chkummer/klonk/README.md

# klonk
A single key USB keyboard that helps you at typing your password. It is build using an Arduino comaptible board called 'Pro Micro' and an RFID board called 'MFRC522'.
