chkummer/klonk/case/README.md

#Case 
This folder contains files for the case which you may 3d print.
The case was degigned using TurboCAD (<filename>.tcd) and then exported into DXF (<filename>.dxf) for importing into other CAD Applications and into STL (<filename>.stl) files for importing them into a Slicer-Software (to prepare for your 3D Printer). 

##Files

###klonk_rfid_rc522 case
Printed 3d case
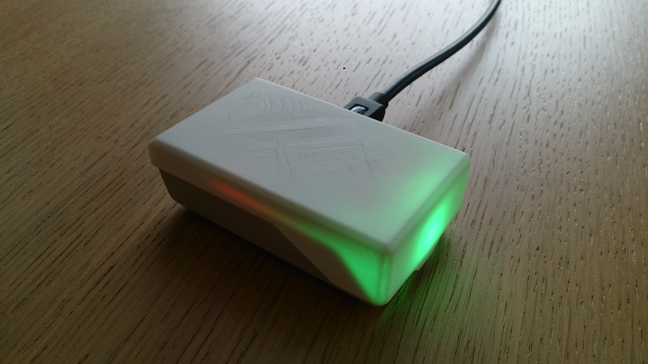
[picture p1: case/klonk_rfid_rc522_case.jpg]
3d case

Breadboard view
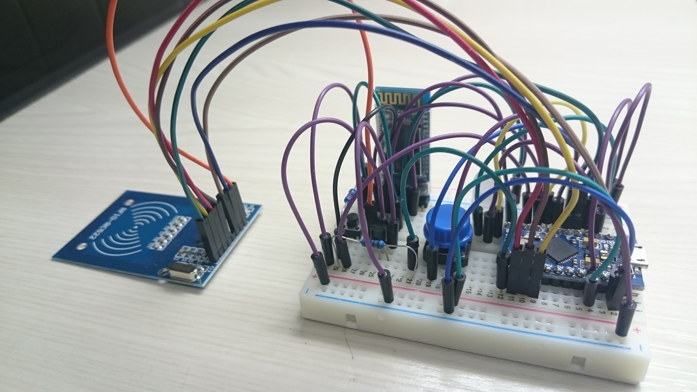
[picture p2: case/klonk_rfid_rc522_bb.jpg]

Electronic parts
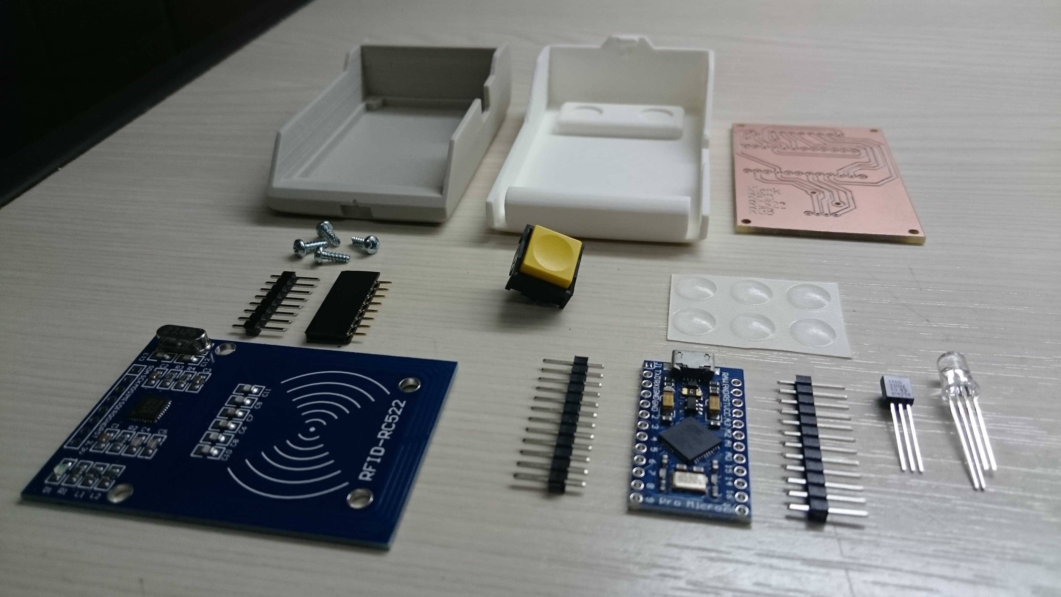
[picture p3: case/klonk_rfid_rc522_parts_01.jpg]

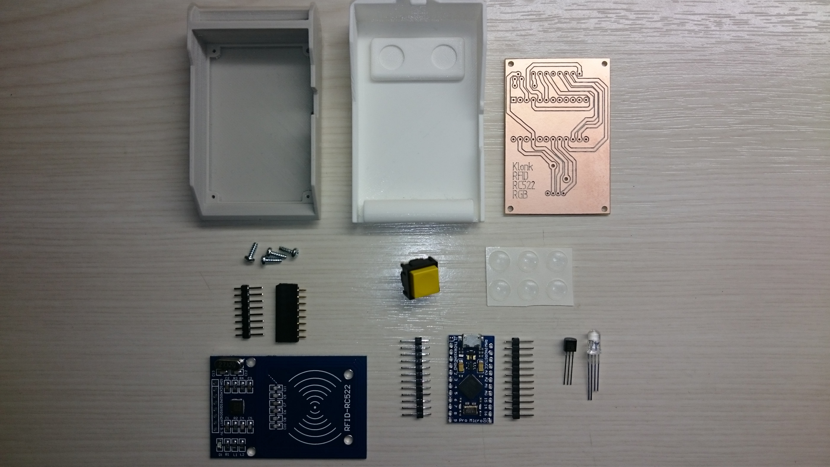
[picture p4: case/klonk_rfid_rc522_parts_02.jpg]

Electronic parts soldered
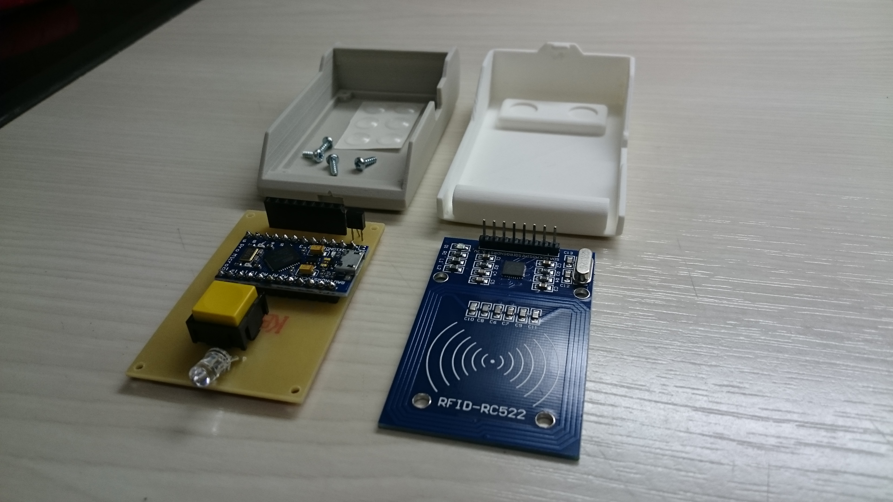
[picture p5: case/klonk_rfid_rc522_soldered.jpg]


###klonk_fingerprint case
Customised standard box case
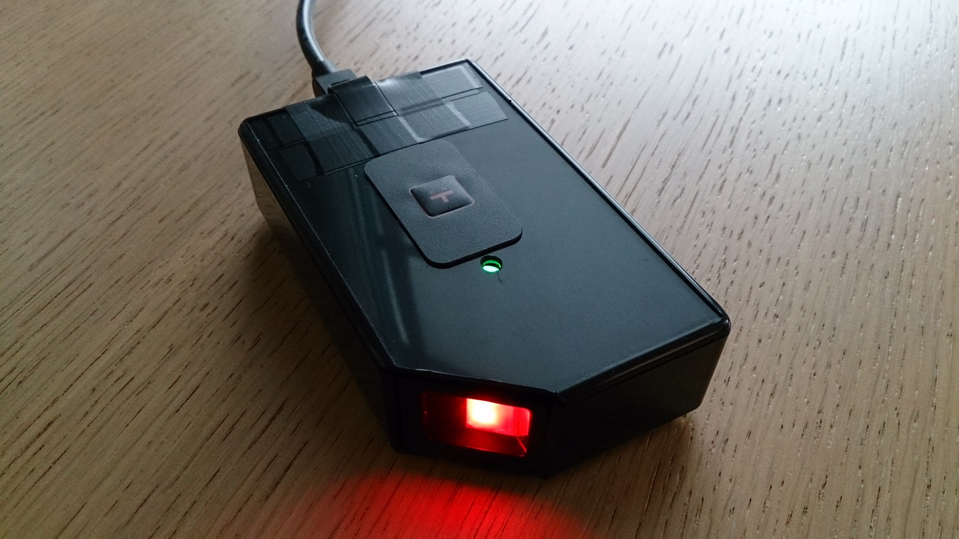
[picture p6: case/klonk_fp_case.jpg]
Customised case

Breadboard view
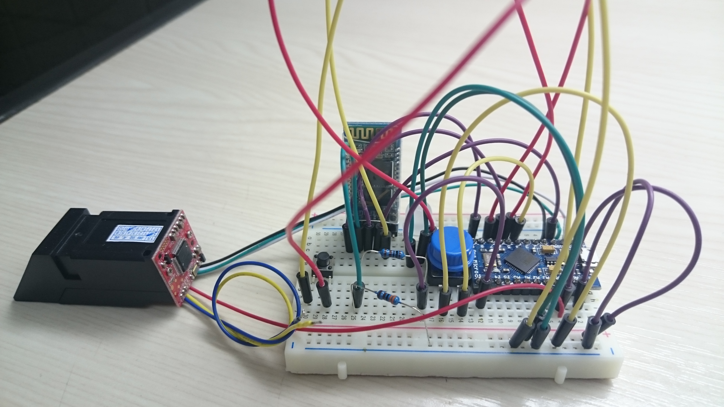
[picture p7: case/klonk_fb_bb.jpg]
