chkummer/klonk/electronics/klonk_rfid_rc522_green_led/klonk_bt.png

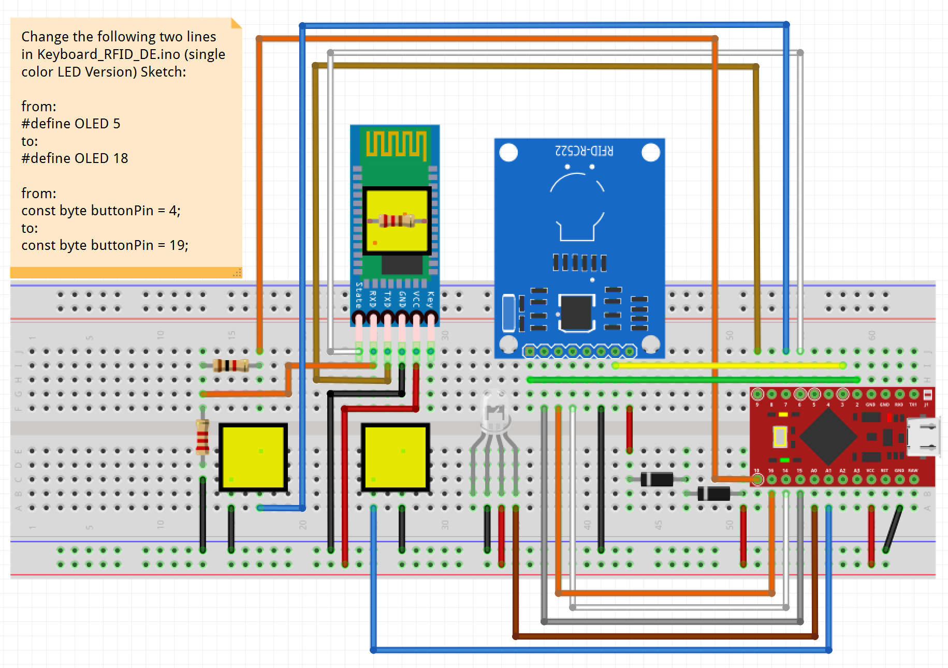
electronics/klonk_rfid_rc522_green_led/klonk_bt.png
