chkummer/klonk/case/klonk_top.stl

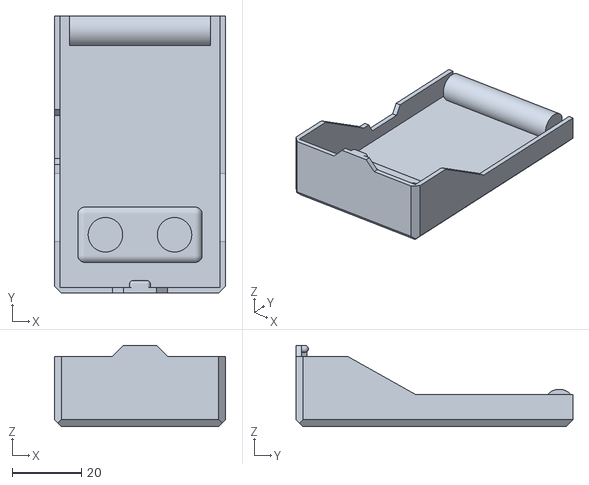
[picture p15: CAD file, 2016-12-01]
case/klonk_top.stl
49.6 x 80.2 x 23.5
