chkummer/klonk/case/klonk_base.stl

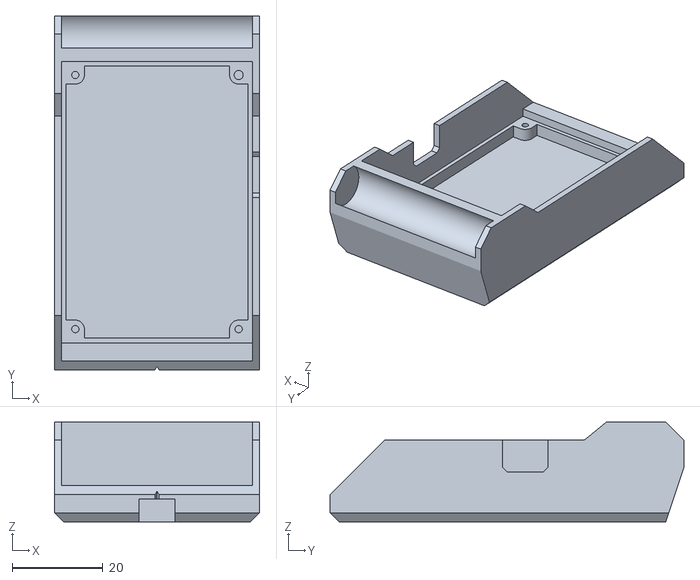
[picture p16: CAD file, 2016-10-09]
case/klonk_base.stl
45.2 x 78.0 x 22.0
