chkummer/klonk/(list of files, cad)

Other CAD files:
case/klonk_base.dxf
case/klonk_top.dxf
