chkummer/klonk/electronics/klonk_rfid_rc522_rgb_led/klonk_rfid_rc522_rgb_led_pcb.pdf

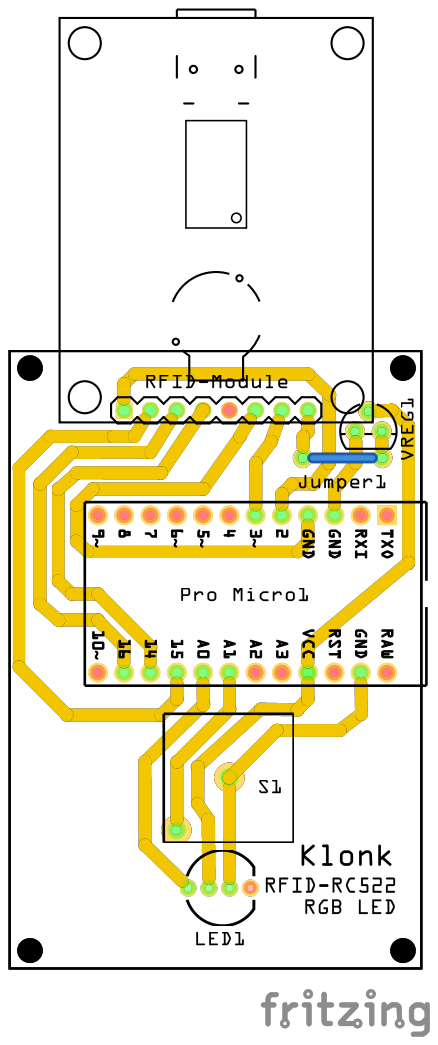
[picture p17: page 1]
