chkummer/klonk/electronics/klonk_rfid_rc522_green_led/klonk_rfid_rc522_green_led_breadboard.pdf

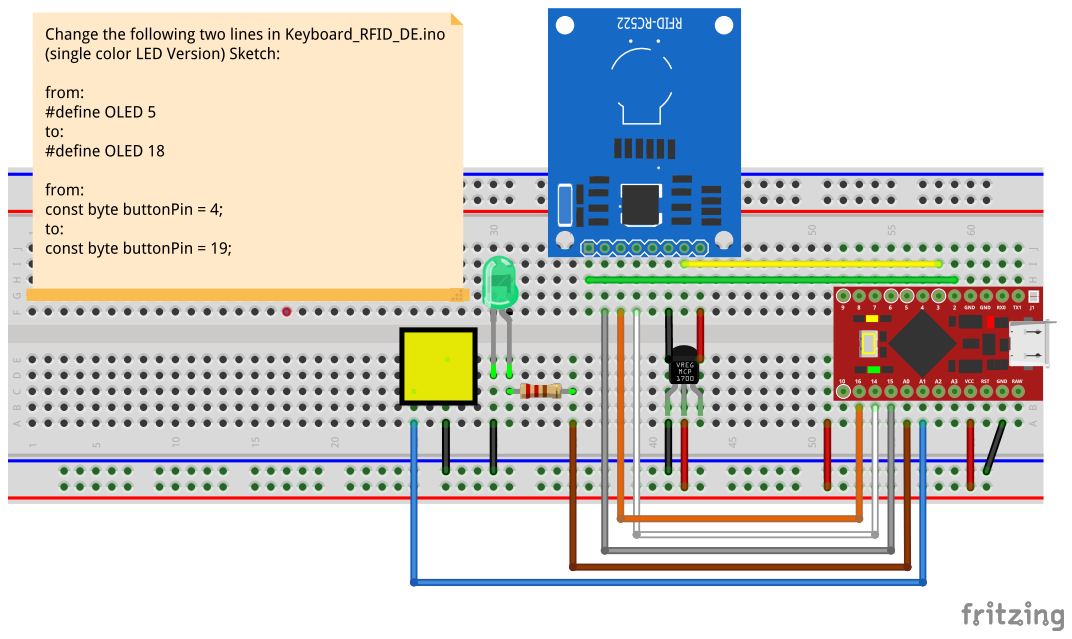
[picture p18: page 1]
