chkummer/klonk/electronics/klonk_rfid_rc522_rgb_led/klonk_rfid_rc522_rgb_led_breadboard.pdf

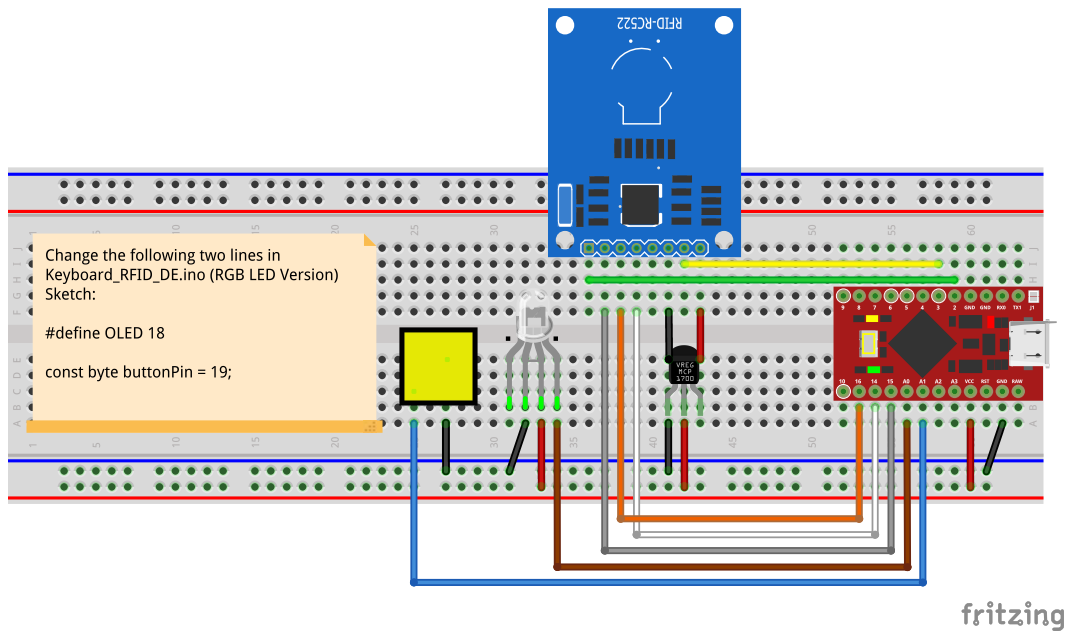
[picture p19: page 1]
