chkummer/klonk/electronics/klonk_rfid_rc522_rgb_led/klonk_rfid_rc522_rgb_led_schematics.pdf

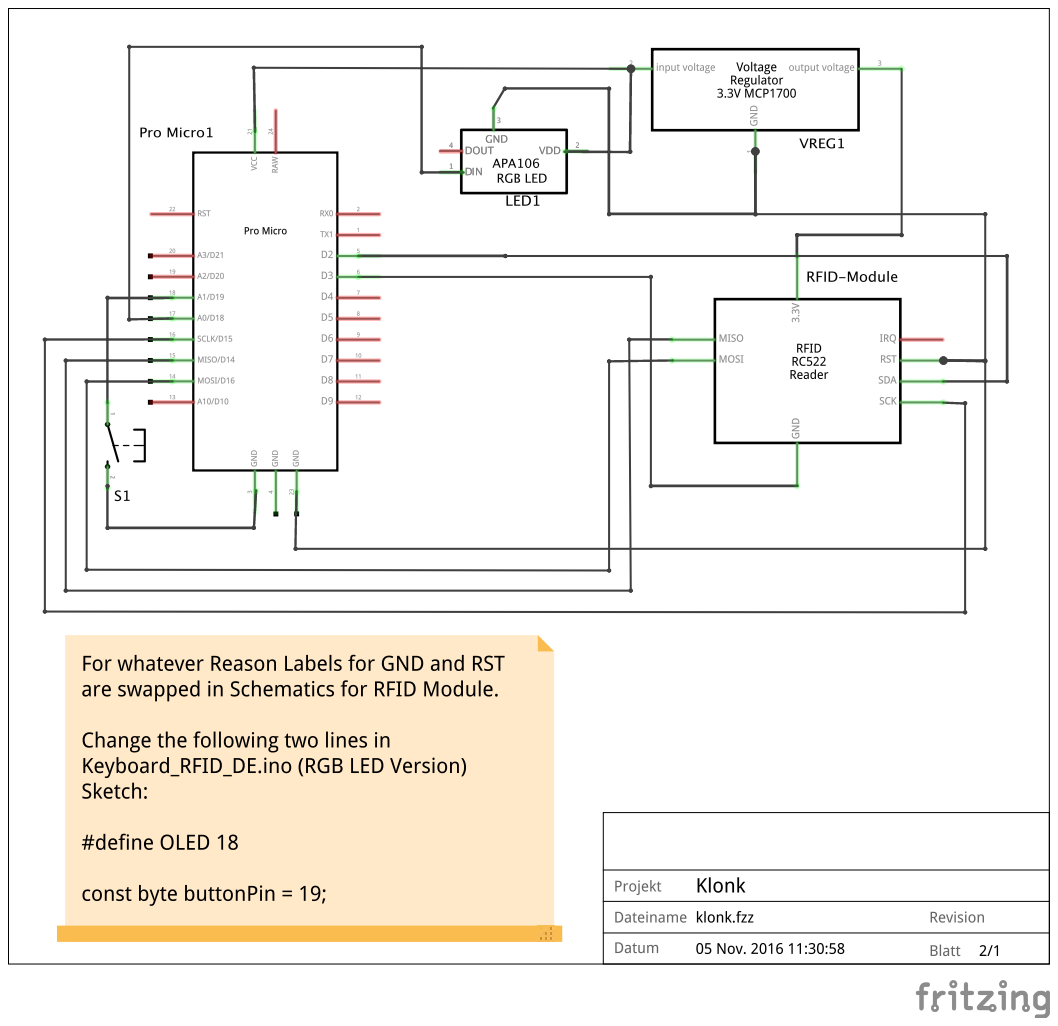
[picture p20: page 1]
