chkummer/klonk/electronics/klonk_rfid_rc522_green_led/klonk_rfid_rc522_green_led_pcb.pdf

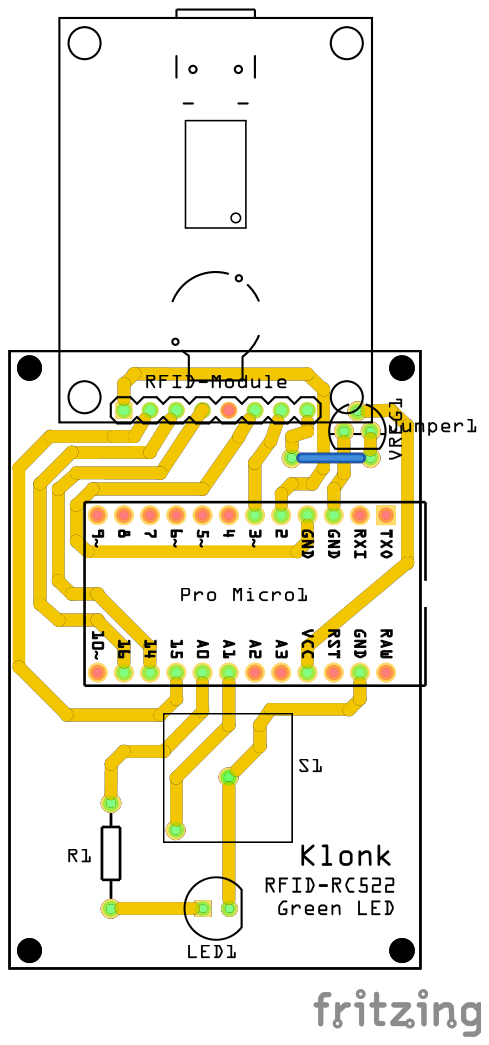
[picture p21: page 1]
