chkummer/klonk/electronics/klonk_rfid_rc522_green_led/klonk_rfid_rc522_green_led_schematics.pdf

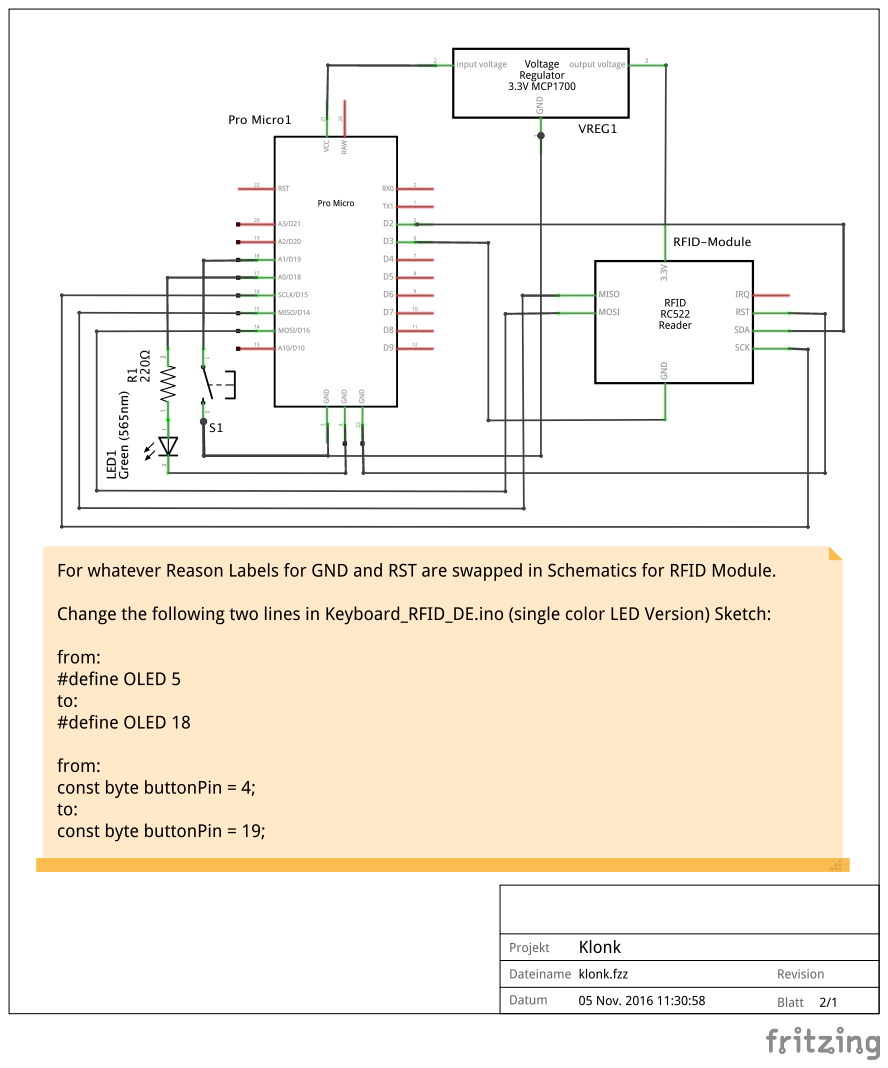
[picture p22: page 1]
