chkummer/klonk/(list of files, drawings)

Other design files:
electronics/klonk_rfid_rc522_green_led/klonk_bt.fzz
electronics/klonk_rfid_rc522_green_led/klonk_rfid_rc522_green_led.fzz
electronics/klonk_rfid_rc522_rgb_led/klonk_bt.fzz
electronics/klonk_rfid_rc522_rgb_led/klonk_rfid_rc522_rgb_led.fzz
