chkummer/klonk/firmware/Klonk/usToDE.h

// ummappen für deutsches KeyBoard-Layout
// klappt nicht für alle Zeichen (z.B. Umlaute)

#include <avr/pgmspace.h>

const unsigned char PROGMEM usToDE[256] =
{
  //  0   1   2   3   4   5   6   7   8   9   A   B   C   D   E   F
  //                                                                   // 0
      0,  0,  0,  0,  0,  0,  0,  0,  8,  9, 10,  0,  0, 13,  0,  0,
  //                                                                   // 1
      0,  0,  0,  0,  0,  0,  0,  0,  0,  0,  0,  0,  0,  0,  0,  0,
  // SP   !   "   #   $   %   &   '   (   )   *   +   ,   -   .   /    // 2
     32,125, 93,  0, 92, 37, 94, 45, 42, 40, 35, 33, 44, 47, 46, 38,
  //  0   1   2   3   4   5   6   7   8   9   :   ;   <   =   >   ?    // 3
     48, 49, 50, 51, 52, 53, 54, 55, 56, 57, 62, 60, 92, 41,124, 95,
  //  @   A   B   C   D   E   F   G   H   I   J   K   L   M   N   O    // 4
      0, 65, 66, 67, 68, 69, 70, 71, 72, 73, 74, 75, 76, 77, 78, 79,
  //  P   Q   R   S   T   U   V   W   X   Y   Z   [   \   ]   ^   _    // 5
     80, 81, 82, 83, 84, 85, 86, 87, 88, 90, 89,  0,  0,  0, 61, 63,
  //  `   a   b   c   d   e   f   g   h   i   j   k   l   m   n   o    // 6
     43, 97, 98, 99,100,101,102,103,104,105,106,107,108,109,110,111,
  //  p   q   r   s   t   u   v   w   x   y   z   {   |   }   ~   DEL  // 7
    112,113,114,115,116,117,118,119,120,122,121,  0,  0,  0,  0,  0,
  //                                                                   // 8
      0,  0,  0,  0,  0,  0,  0,  0,  0,  0,  0,  0,  0,  0,  0,  0,
  //                                                                   // 9
      0,  0,  0,  0,  0,  0,  0,  0,  0,  0,  0,  0,  0,  0,  0,  0,
  //              £                                                    // A
      0,  0,  0,124,  0,  0,  0,  0,  0,  0,  0,  0,  0,  0,  0,  0,
  //                                                                   // B
      0,  0,  0,  0,  0,  0,  0,  0,  0,  0,  0,  0,  0,  0,  0,  0,
  //                  Ä                                                // C
      0,  0,  0,  0,  0,  0,  0,  0,  0,  0,  0,  0,  0,  0,  0,  0,
  //                          Ö                       Ü                // D
      0,  0,  0,  0,  0,  0,  0,  0,  0,  0,  0,  0,  0,  0,  0,  0,
  //  à               ä           ç   è   é                            // E
     34,  0,  0,  0, 39,  0,  0, 36,123, 58,  0,  0,  0,  0,  0,  0,
  //                          ö                       ü                // F
      0,  0,  0,  0,  0,  0, 59,  0,  0,  0,  0,  0, 91,  0,  0,  0,
};
