chkummer/klonk/(commit log)

2016-10-06 Initial version of the case
    [klonk_base.dxf, klonk_base.stl]
2016-10-06 first version of the case using a top to do the key press
    [klonk_base.dxf, klonk_base.stl, klonk_top.dxf, klonk_top.stl]
2016-10-06 improved back axis on case
    [klonk_base.dxf, klonk_base.stl, klonk_top.dxf, klonk_top.stl]
2016-10-06 added front hook and give usb connector more space
    [klonk_base.dxf, klonk_base.stl, klonk_top.dxf, klonk_top.stl]
2016-10-06 Version for Arduino Pro Micro
2016-10-06 Klonk for RFID-RC522 with fingerprint sensor
2016-10-06 Adjust directory names for Arduino IDE
2016-10-09 modified case for less toleracnces and improved guiding
    [klonk_base.dxf, klonk_base.stl, klonk_top.dxf, klonk_top.stl]
2016-10-14 Klonk: Arduino Pro Micro, RFID-RC522, RGB-LED - added support for RGB-LED (APA106)
2016-10-14 klonk: Arduino Pro Micro, Fingerprint, RGB-LED (APA 106)
2016-10-16 added the initial electronics files and updated/renamed readme files
    [klonk.fzz]
2016-10-24 Inserted a while loop to main loop () It's weird - it should work without the while loop but it doesn't. Had to add this ugly work arround :-(
    [Keyboard_RFID_DE_Fingerprint.ino]
2016-10-30 klonk: Arduino Pro Micro, RFID-RC522, RGB-L, HC-05
    Added support for logging out the desktop when bluetooth HC-05 module and mobile
    phone are not paired.
2016-10-30 fixed PCB view for MicroPro added button. first attempt for pcb layout.
    [klonk.fzz]
2016-10-31 klonk: Arduino Pro Micro, Fingerprint, RGB, HC-05
    Added support for logging out the desktop when bluetooth HC-05 module
    and mobile phone are not paired.
2016-11-02 RGB brigthness is lowered, spelling corrections
    [Keyboard_RFID_DE_Fingerprint_BT.ino]
2016-11-03 modified PCB for milling. added gerber files
    [klonk.fzz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]
2016-11-12 Updated "Bill of Materials"
2016-11-23 Added Serial.println to setup() to avoid freeze
    [Keyboard_RFID_DE.ino, Keyboard_RFID_DE_BT.ino]
2016-11-24 Added support for 2nd user and user select button
2016-11-27 Added additional description to RGB-LED
2016-11-27 Added support for 2nd user and user select button All RFID-RC522 versions now support 2nd user/password
2016-11-27 Added support for 2nd user and user select button All klonk fingerprint versions now support 2nd user/password
2016-11-28 Added klonk_bt.fzz klonk_bt.fzz shows the wiring of Keyboard_RFID_DE_BT_Serial
    [klonk_bt.fzz]
2016-12-01 added voltage regualtor MCP1700, renaming and rearranging structure
    [klonk.fzz, klonk_rfid_rc522_green_led.fzz, klonk_top.dxf, klonk_top.stl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]
2016-12-01 added rgb led APA106
    [klonk_rfid_rc522_rgb_led.fzz]
2016-12-03 Updated klonk_bt.fzz
    [klonk_bt.fzz]
2016-12-03 fixed pins of APA106 LED. modified readme.
    [klonk_rfid_rc522_rgb_led.fzz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]
2016-12-03 Removed klonk_bt.fzz and klonk_bt.png
    [klonk_bt.fzz]
2016-12-06 fixed pcb (VREG was too close to a copper trace which caused problems on the pcb milling side)
    [klonk_rfid_rc522_rgb_led.fzz]
2016-12-07 fixed pcb iconnector pads for button
    [klonk_rfid_rc522_rgb_led.fzz]
2016-12-07 Added comments for OLED, buttonPin and RGB APA-106
2016-12-09 login(): Replaced Keyboard.write with prtKbdStrg
    [Keyboard_RFID_DE.ino, Keyboard_RFID_DE_BT.ino, Keyboard_RFID_DE_BT_Serial.ino, Keyboard_RFID_DE_Fingerprint.ino, Keyboard_RFID_DE_Fingerprint_BT.ino, Keyboard_RFID_DE_Fingerprint_BT_Serial.ino]
2016-12-09 Updated case/README.md
2016-12-09 Updated case/README.md and added pics
2016-12-10 Fixed reset function of PN532 version
    [Keyboard_RFID_DE.ino]
2017-01-26 Fix: Enable login/logut functions Fix: Cleanup merged Tag Handling Code
    [Klonk.ino, token.cpp, token.h]
2017-01-26 Fix: Fix token output
    [Klonk.h, Klonk.ino, token.cpp]
2017-03-19 added information on how to get a pcb
